jpangburn/Solar_Tracker_Positional_TFT/(commit log)

2021-09-23 Set correct start/end times for current setup
2021-09-23 Add east limit switch code with optional enable
2021-10-05 Fix automove button hold delay, tracking flag
2021-10-27 Add equation of time adjustment, switch actuators
2021-11-18 switch to Solar Position library
2022-07-21 Set Clock power to an output pin
2022-08-03 Switched SDA/SCL for test
2022-09-01 switched to Mega 2560
